dalba-workshop/Impact-Synth-Hardware/datasheet/JetsonNanoDevKitMec.jpg

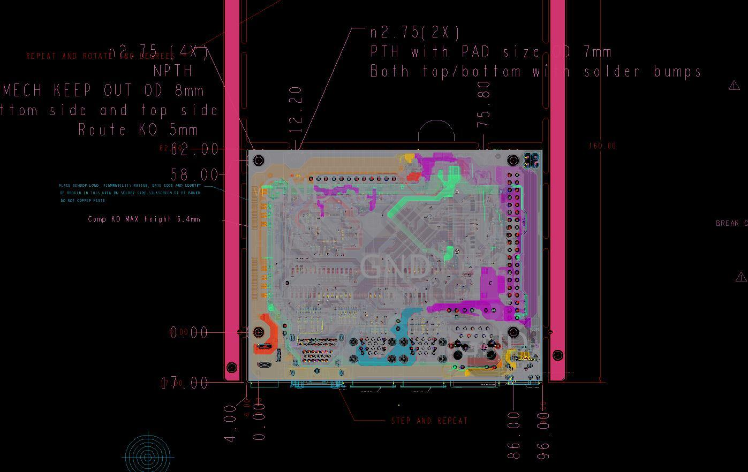
datasheet/JetsonNanoDevKitMec.jpg
