dalba-workshop/Impact-Synth-Hardware/cad/3dPrint/jnCase-Body.step

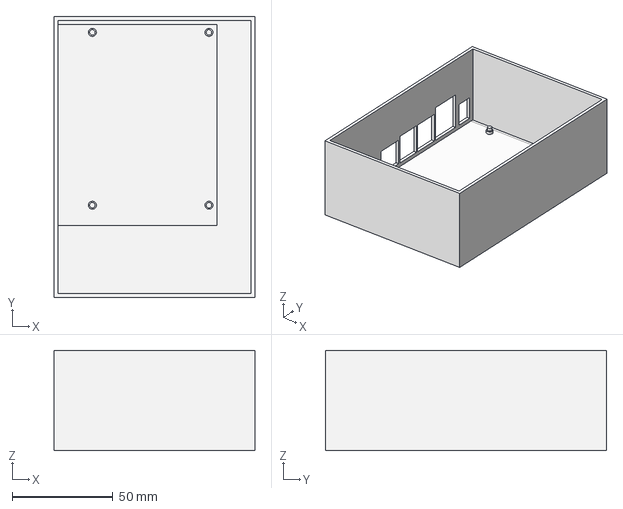
[picture p2: CAD file, 2023-01-26]
cad/3dPrint/jnCase-Body.step
100.0 x 140.0 x 50.0 mm
