dalba-workshop/Impact-Synth-Hardware/cad/case/lid.FCStd

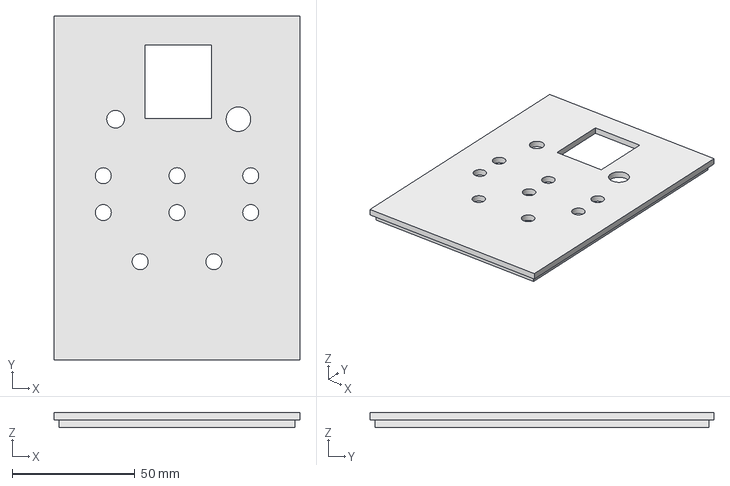
[picture p3: CAD file, 2023-01-26]
cad/case/lid.FCStd
100.0 x 140.0 x 6.00 mm
