dalba-workshop/Impact-Synth-Hardware/cad/jetsonSheild.FCStd

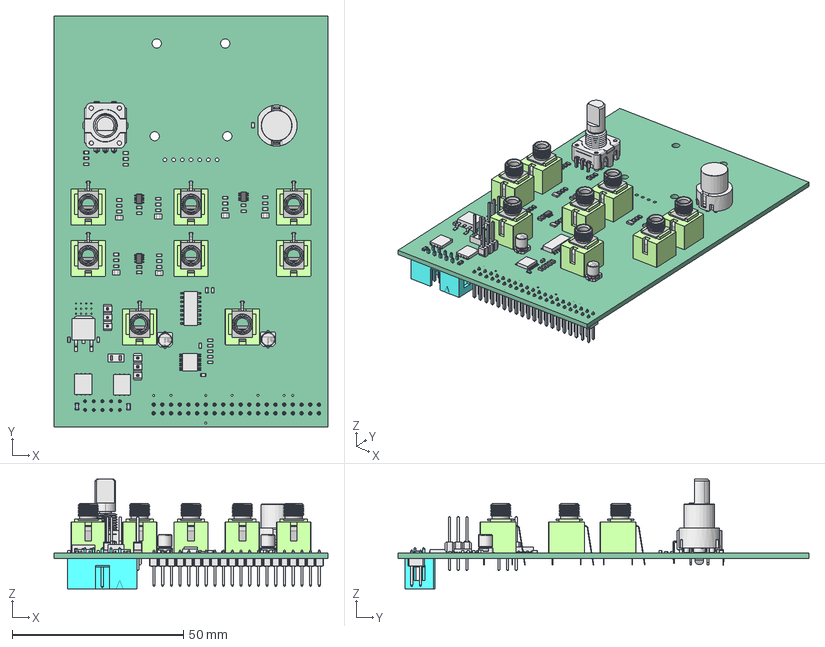
[picture p4: CAD file, 2023-01-11]
cad/jetsonSheild.FCStd
80.0 x 120.0 x 32.1 mm
Pcb_28d6
R8_R_0603_1608Metric_eae88b4e4b48 x 24
C12_C_0603_1608Metric_b996f4777426 x 18
U2_part_7a2c3e8a9f98
J14_part_9095210408f7 x 2
Q1_part_363d7e130ef1 x 2
FB2_HI0805O121R-10_937ccf488538 x 2
R18_part_2204fca52d41 x 6
Pin 3 x 8
Pin 2 x 8
Pin 1 x 8
Socket x 8
U8_part_a843a6058fb9
J15_C-87224-2_f0da443ed696
Base_Φ4Capacitor x 2
capicitor_4x5.5x1 x 2
BODY-SO x 3
LEAD-SO x 3
LEAD-SO001 x 3
LEAD-SO002 x 3
LEAD-SO003 x 3
LEAD-SO004 x 3
LEAD-SO005 x 3
LEAD-SO006 x 3
LEAD-SO007 x 3
ENC1_PEC11R-4X15F-S_891faaeb0f68
U1_part_3ea94191c17d
D6R60F2LFS_PART1
J4_78-5110-5530-9_6b1bc2c0cfd2
J2_MSBR-1_21fd95f2a57d
