dalba-workshop/Impact-Synth-Hardware/datasheet/P3448_Module.stp

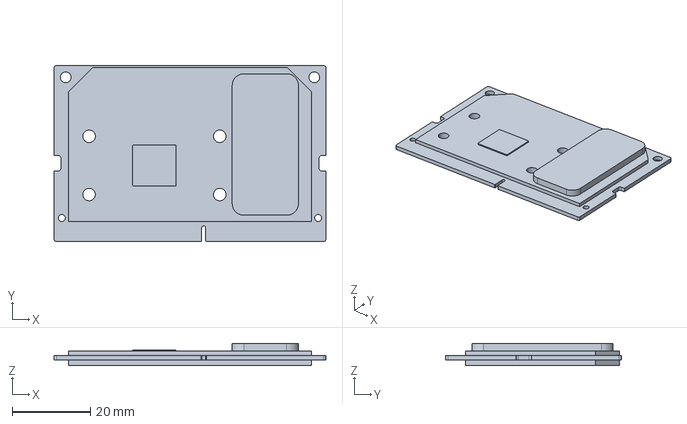
[picture p5: CAD file, 2022-12-26]
datasheet/P3448_Module.stp
69.6 x 45.0 x 5.70 mm
