dalba-workshop/Impact-Synth-Hardware/(list of files, cad)

Other CAD files:
cad/3dPrint/lid-Body.step
