dalba-workshop/Impact-Synth-Hardware/hardwareDesign/shield/shield.kicad_pcb

## KiCad design hardwareDesign/shield/shield.kicad_pcb (2023-01-12)

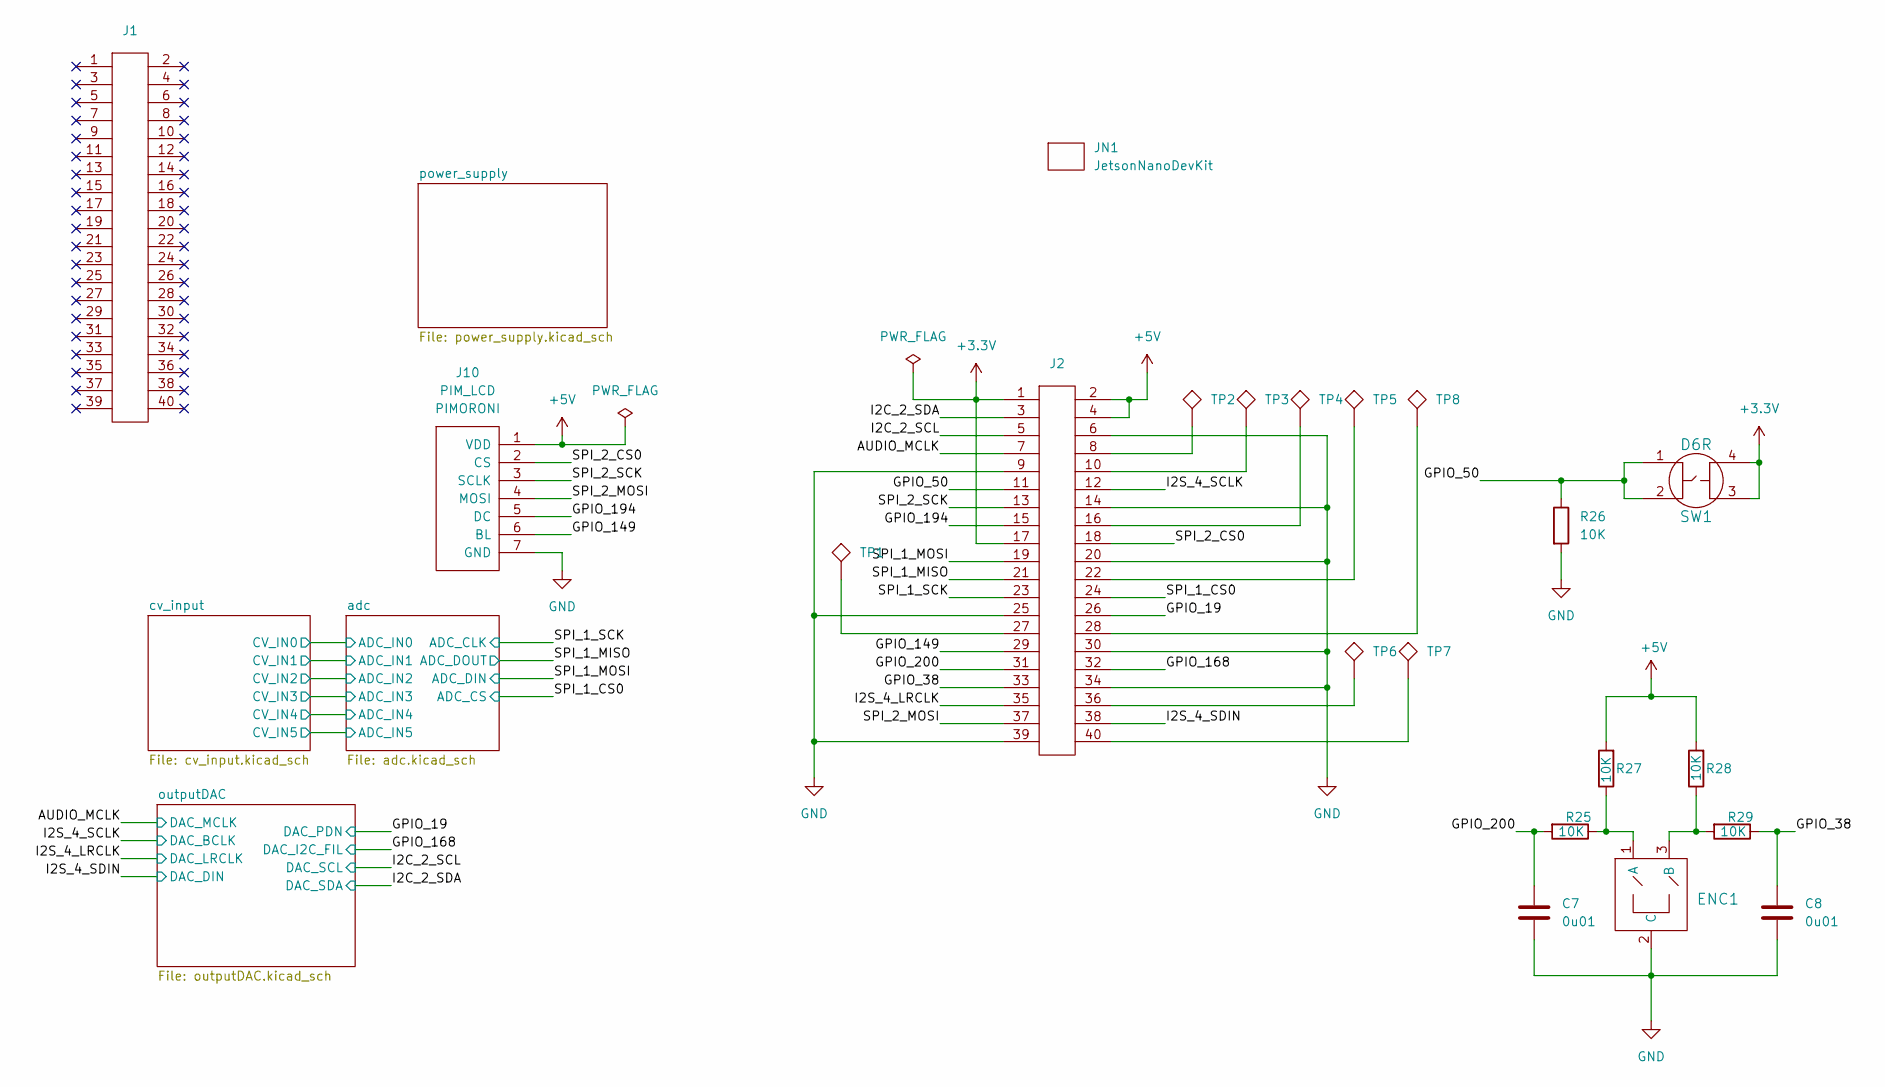
[picture p6: schematic shield.kicad_sch]

Parts:
C7, C8: 0.01uf_0603_50V; SMD_0603[1608]; Part Number VJ0603Y103KXACW1BC
ENC1: BOURNS_PEC11R_DET; BOURNS_ENCODER; Part Number PEC11R-4220F-N0024
J1: 40_POS_RIBBON; 40_POS_2.54mm; Part Number IDSD-20-D-04.00-T-G-RW
J2: 40_POS_Header; 40_POS_2.54mm; Part Number 10129381-940002BLF
J10: PIM_LCD; PIMORONI_LCD_240x240; Part Number PIMORONI_LCD_240x240
JN1: JetsonNano; jetsonNanoDev; Part Number RCG04021K00FKED
R25, R27, R28, R29: 10K_0603_2; SMD_0603[1608]; Part Number SFR03EZPF1002
R26: 10K_0603; SMD_0603[1608]; Part Number AC0603FR-0710KL
SW1: D6R; Part Number D6R60F1LFS
TP1, TP2, TP3, TP4, TP5, TP6, TP7, TP8: test_point_TH_Small; test_point_0.6mm

Connections:
+3V3: J2.1, J2.17, SW1.3, SW1.4; also elsewhere on the board
+5V: J2.2, J2.4, J10.1 (VDD), R27.2, R28.2; also elsewhere on the board
/AUDIO_MCLK: J2.7; also elsewhere on the board
/GPIO_19: J2.26; also elsewhere on the board
/GPIO_38: C8.1, J2.33, R29.1
/GPIO_50: J2.11, R26.1, SW1.1, SW1.2
/GPIO_149: J2.29, J10.6 (BL)
/GPIO_168: J2.32; also elsewhere on the board
/GPIO_194: J2.15, J10.5 (DC)
/GPIO_200: C7.1, J2.31, R25.2
/I2C_2_SCL: J2.5; also elsewhere on the board
/I2C_2_SDA: J2.3; also elsewhere on the board
/I2S_4_LRCLK: J2.35; also elsewhere on the board
/I2S_4_SCLK: J2.12; also elsewhere on the board
/I2S_4_SDIN: J2.38; also elsewhere on the board
/SPI_1_CS0: J2.24; also elsewhere on the board
/SPI_1_MISO: J2.21; also elsewhere on the board
/SPI_1_MOSI: J2.19; also elsewhere on the board
/SPI_1_SCK: J2.23; also elsewhere on the board
/SPI_2_CS0: J2.18, J10.2 (CS)
/SPI_2_MOSI: J2.37, J10.4 (MOSI)
/SPI_2_SCK: J2.13, J10.3 (SCLK)
GND: C7.2, C8.2, ENC1.2 (C), J2.6, J2.9, J2.14, J2.20, J2.25, J2.30, J2.34, J2.39, J10.7 (GND), R26.2; also elsewhere on the board
unnamed: ENC1.1 (A), R25.1, R27.1
unnamed: ENC1.3 (B), R28.1, R29.2
unnamed: J2.8, TP2.1
unnamed: J2.10, TP3.1
unnamed: J2.16, TP4.1
unnamed: J2.22, TP5.1
unnamed: J2.27, TP1.1
unnamed: J2.28, TP8.1
unnamed: J2.36, TP6.1
unnamed: J2.40, TP7.1

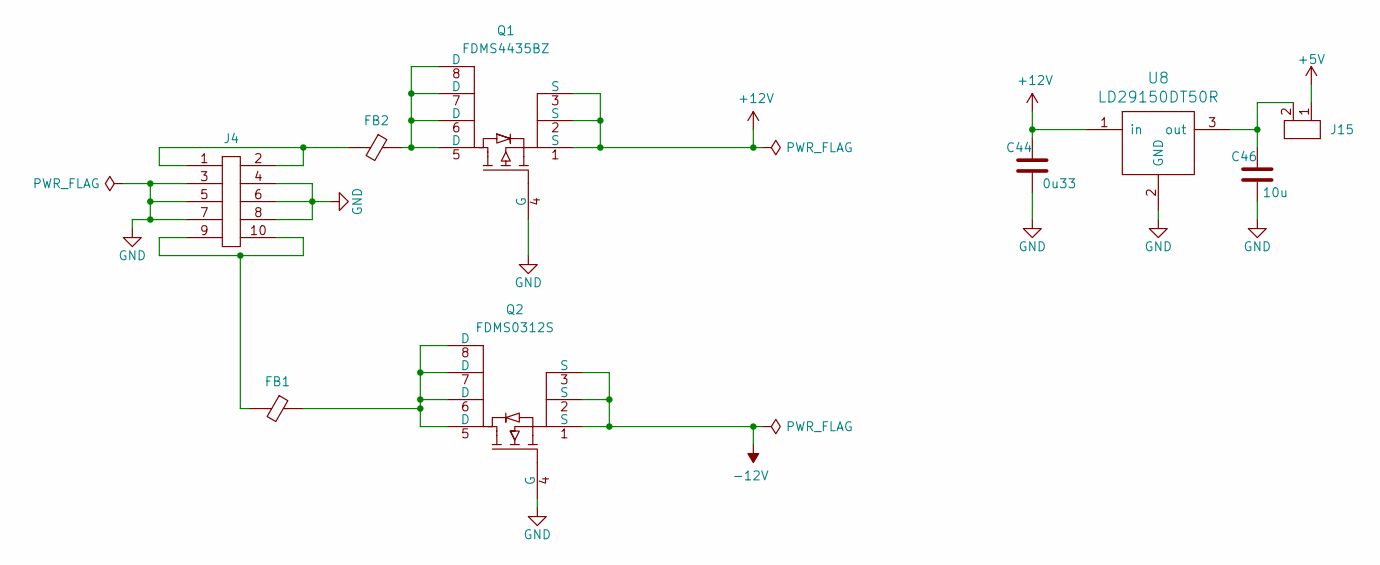
[picture p7: schematic power_supply.kicad_sch]

Parts:
C44: 0.33uf_0603_25V; SMD_0603[1608]; Part Number CC0603KRX7R8BB334
C46: 10uf_0603_25V; SMD_0603[1608]; Part Number GRT188R61E106ME13D
FB1, FB2: FB_HZ0805; Part Number HZ0805C202R-10
J4: 10_POS_PIN_HEADER_ALT; 05x02_2.54_pitch_pin_header; Part Number 61201021621
J15: 2x1_PIN_HEADER; 02x01_2.54_pitch_pin_header; Part Number 67996-400HLF
Q1: FDMS4435BZ; Power-56-8; Part Number FDMS4435BZ
Q2: FDMS0312S; Power-56-8; Part Number FDMS0312S
U8: LD29150DT50R; TO-252-3_ST; Part Number LD29150DT50R

Connections:
+5V: J15.1; also elsewhere on the board
+12V: C44.1, Q1.1 (S), Q1.2 (S), Q1.3 (S), U8.1 (in); also elsewhere on the board
-12V: Q2.1 (S), Q2.2 (S), Q2.3 (S); also elsewhere on the board
GND: C44.2, C46.2, J4.3, J4.4, J4.5, J4.6, J4.7, J4.8, Q1.4 (G), Q2.4 (G), U8.2 (GND); also elsewhere on the board
unnamed: C46.1, J15.2, U8.3 (out)
unnamed: FB1.1, Q2.5 (D), Q2.6 (D), Q2.7 (D), Q2.8 (D)
unnamed: FB1.2, J4.9, J4.10
unnamed: FB2.1, Q1.5 (D), Q1.6 (D), Q1.7 (D), Q1.8 (D)
unnamed: FB2.2, J4.1, J4.2

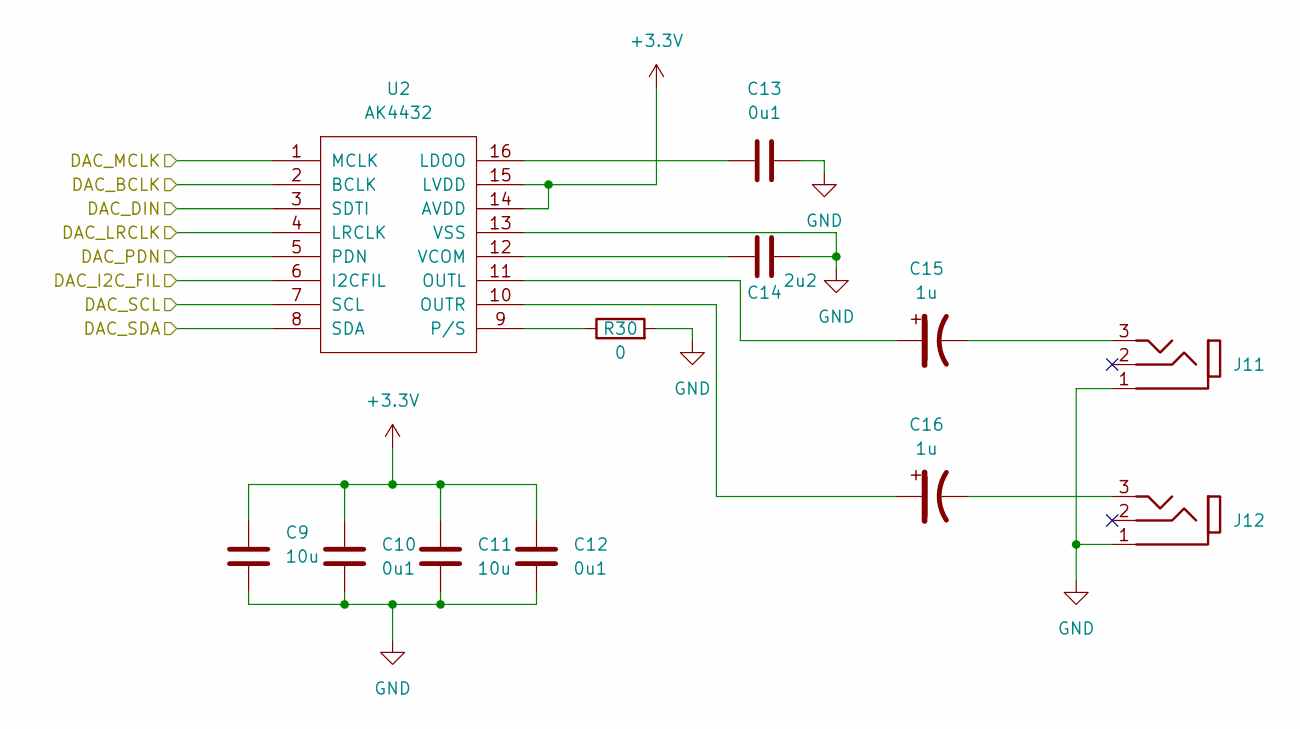
[picture p8: schematic outputDAC.kicad_sch]

Parts:
C9, C11: 10uf_0603_25V; SMD_0603[1608]; Part Number GRT188R61E106ME13D
C10, C12, C13: 0.1uf_0603_10V; SMD_0603[1608]; Part Number 885012206020
C14: 2.2uf_0603_10V; SMD_0603[1608]; Part Number 885012106011
C15, C16: 1uf_4.3mm_50V_POL_LP; WE_4mm_cap; Part Number RSVVS010M1UBC3001U
J11, J12: WQP419; Part Number WQP-WQP419GR
R30: 0_0603; SMD_0603[1608]; Part Number CRCW06030000Z0EAC
U2: AK4432; TSSOP-16; Part Number AK4432VT

Connections:
+3V3: C9.1, C10.1, C11.1, C12.1, U2.14 (AVDD), U2.15 (LVDD); also elsewhere on the board
/AUDIO_MCLK: U2.1 (MCLK); also elsewhere on the board
/GPIO_19: U2.5 (PDN); also elsewhere on the board
/GPIO_168: U2.6 (I2CFIL); also elsewhere on the board
/I2C_2_SCL: U2.7 (SCL); also elsewhere on the board
/I2C_2_SDA: U2.8 (SDA); also elsewhere on the board
/I2S_4_LRCLK: U2.4 (LRCLK); also elsewhere on the board
/I2S_4_SCLK: U2.2 (BCLK); also elsewhere on the board
/I2S_4_SDIN: U2.3 (SDTI); also elsewhere on the board
GND: C9.2, C10.2, C11.2, C12.2, C13.2, C14.1, J11.1, J12.1, R30.2, U2.13 (VSS); also elsewhere on the board
unnamed: C13.1, U2.16 (LDOO)
unnamed: C14.2, U2.12 (VCOM)
unnamed: C15.1, J11.3
unnamed: C15.2, U2.11 (OUTL)
unnamed: C16.1, J12.3
unnamed: C16.2, U2.10 (OUTR)
unnamed: R30.1, U2.9 (P/S)

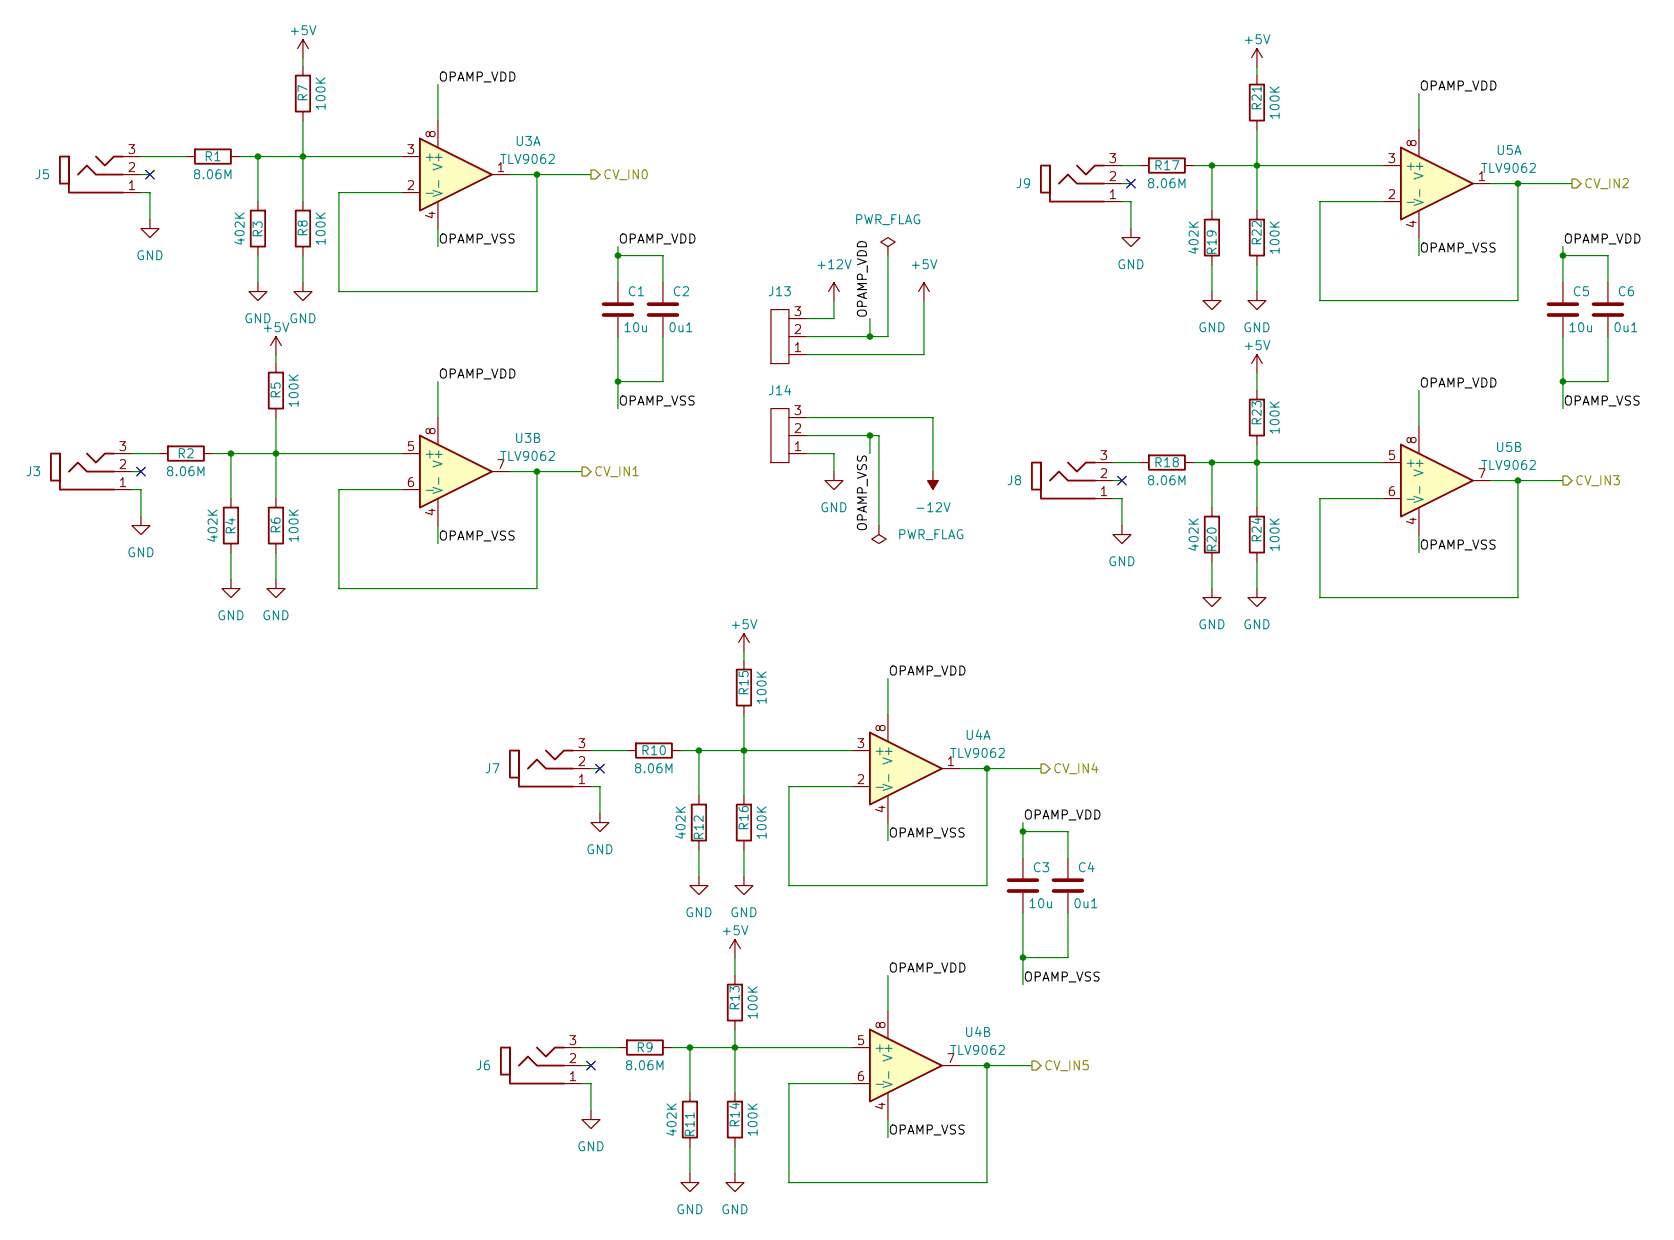
[picture p9: schematic cv_input.kicad_sch]

Parts:
C1, C3, C5: 10uf_0603_25V; SMD_0603[1608]; Part Number GRT188R61E106ME13D
C2, C4, C6: 0.1uf_0603_10V; SMD_0603[1608]; Part Number 885012206020
J3, J5, J6, J7, J8, J9: WQP419; Part Number WQP-WQP419GR
J13, J14: 3x1_PIN_HEADER; 03x01_2.54_pitch_pin_header; Part Number 10129378-903001BLF
R1, R2, R9, R10, R17, R18: 8.06M_0805; SMD_0805[2012]; Part Number RC0805FR-078M06L
R3, R4, R11, R12, R19, R20: 402K_0603; SMD_0603[1608]; Part Number RT0603FRE07402KL
R5, R6, R7, R8, R13, R14, R15, R16, R21, R22, R23, R24: 100K_0603; SMD_0603[1608]; Part Number ERJ-3EKF1003V
U3, U4, U5: TLV9062; SOT23-8; Part Number TLV9062IDDFR

Connections:
+5V: J13.1, R5.2, R7.2, R13.2, R15.2, R21.2, R23.2; also elsewhere on the board
+12V: J13.3; also elsewhere on the board
-12V: J14.3; also elsewhere on the board
/adc/ADC_IN0: U3.1, U3.2 (-); also elsewhere on the board
/adc/ADC_IN1: U3.6 (-), U3.7; also elsewhere on the board
/adc/ADC_IN2: U5.1, U5.2 (-); also elsewhere on the board
/adc/ADC_IN3: U5.6 (-), U5.7; also elsewhere on the board
/adc/ADC_IN4: U4.1, U4.2 (-); also elsewhere on the board
/adc/ADC_IN5: U4.6 (-), U4.7; also elsewhere on the board
/cv_input/OPAMP_VDD: C1.1, C2.1, C3.1, C4.1, C5.1, C6.1, J13.2, U3.8 (V+), U4.8 (V+), U5.8 (V+)
/cv_input/OPAMP_VSS: C1.2, C2.2, C3.2, C4.2, C5.2, C6.2, J14.2, U3.4 (V-), U4.4 (V-), U5.4 (V-)
GND: J3.1, J5.1, J6.1, J7.1, J8.1, J9.1, J14.1, R3.1, R4.1, R6.1, R8.1, R11.1, R12.1, R14.1, R16.1, R19.1, R20.1, R22.1, R24.1; also elsewhere on the board
unnamed: J3.3, R2.2
unnamed: J5.3, R1.2
unnamed: J6.3, R9.2
unnamed: J7.3, R10.2
unnamed: J8.3, R18.2
unnamed: J9.3, R17.2
unnamed: R1.1, R3.2, R7.1, R8.2, U3.3 (+)
unnamed: R2.1, R4.2, R5.1, R6.2, U3.5 (+)
unnamed: R10.1, R12.2, R15.1, R16.2, U4.3 (+)
unnamed: R9.1, R11.2, R13.1, R14.2, U4.5 (+)
unnamed: R17.1, R19.2, R21.1, R22.2, U5.3 (+)
unnamed: R18.1, R20.2, R23.1, R24.2, U5.5 (+)

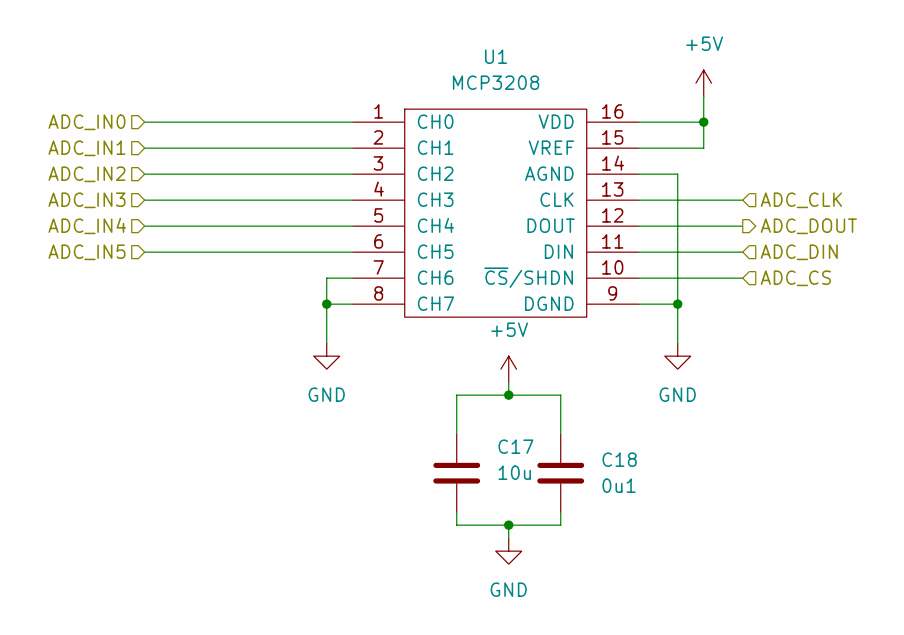
[picture p10: schematic adc.kicad_sch]

Parts:
C17: 10uf_0603_25V; SMD_0603[1608]; Part Number GRT188R61E106ME13D
C18: 0.1uf_0603_10V; SMD_0603[1608]; Part Number 885012206020
U1: MCP3208; SOIC-16; Part Number MCP3208-CI/SL

Connections:
+5V: C17.1, C18.1, U1.15 (VREF), U1.16 (VDD); also elsewhere on the board
/SPI_1_CS0: U1.10 (~CS/SHDN); also elsewhere on the board
/SPI_1_MISO: U1.12 (DOUT); also elsewhere on the board
/SPI_1_MOSI: U1.11 (DIN); also elsewhere on the board
/SPI_1_SCK: U1.13 (CLK); also elsewhere on the board
/adc/ADC_IN0: U1.1 (CH0); also elsewhere on the board
/adc/ADC_IN1: U1.2 (CH1); also elsewhere on the board
/adc/ADC_IN2: U1.3 (CH2); also elsewhere on the board
/adc/ADC_IN3: U1.4 (CH3); also elsewhere on the board
/adc/ADC_IN4: U1.5 (CH4); also elsewhere on the board
/adc/ADC_IN5: U1.6 (CH5); also elsewhere on the board
GND: C17.2, C18.2, U1.7 (CH6), U1.8 (CH7), U1.9 (DGND), U1.14 (AGND); also elsewhere on the board

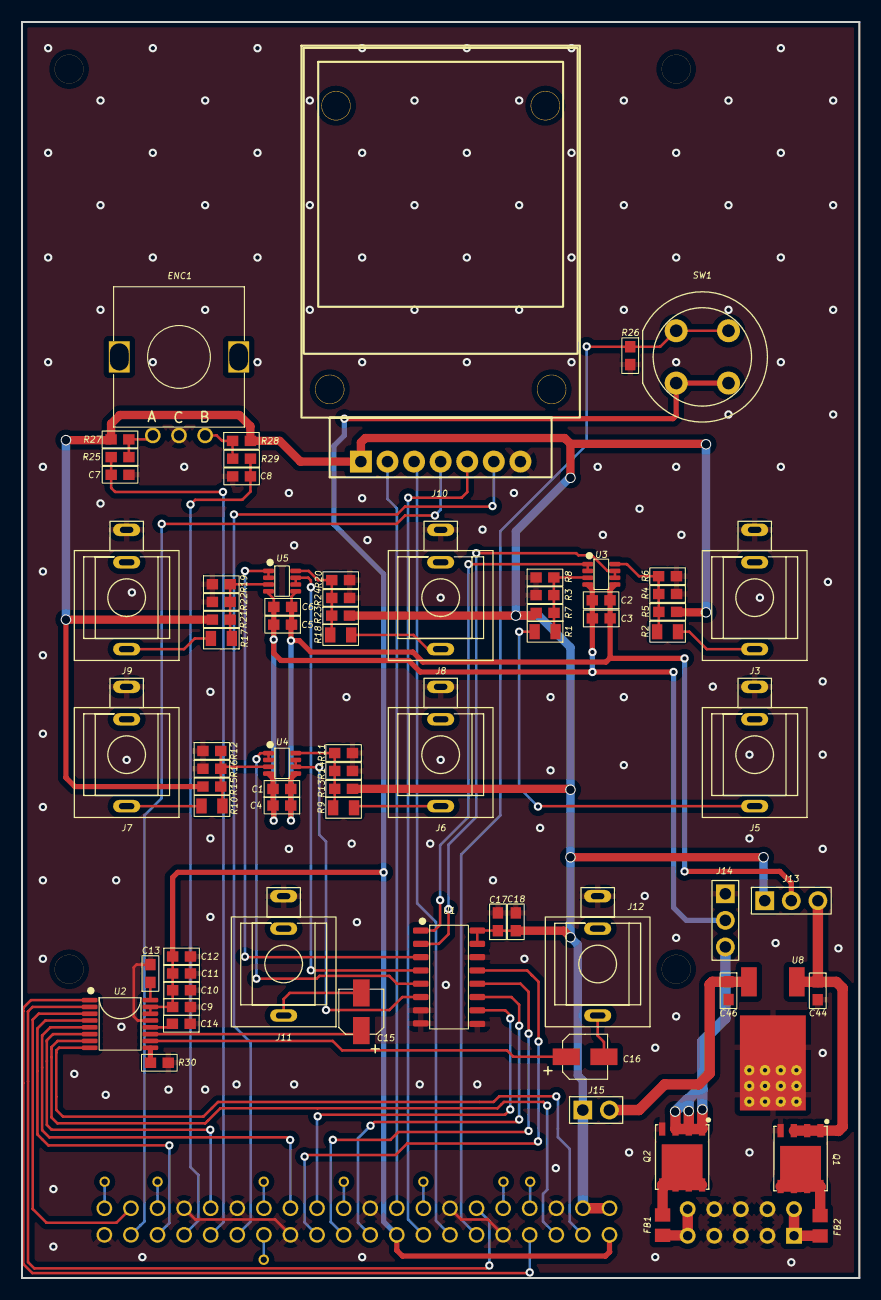
[picture p11: board shield.kicad_pcb from above]

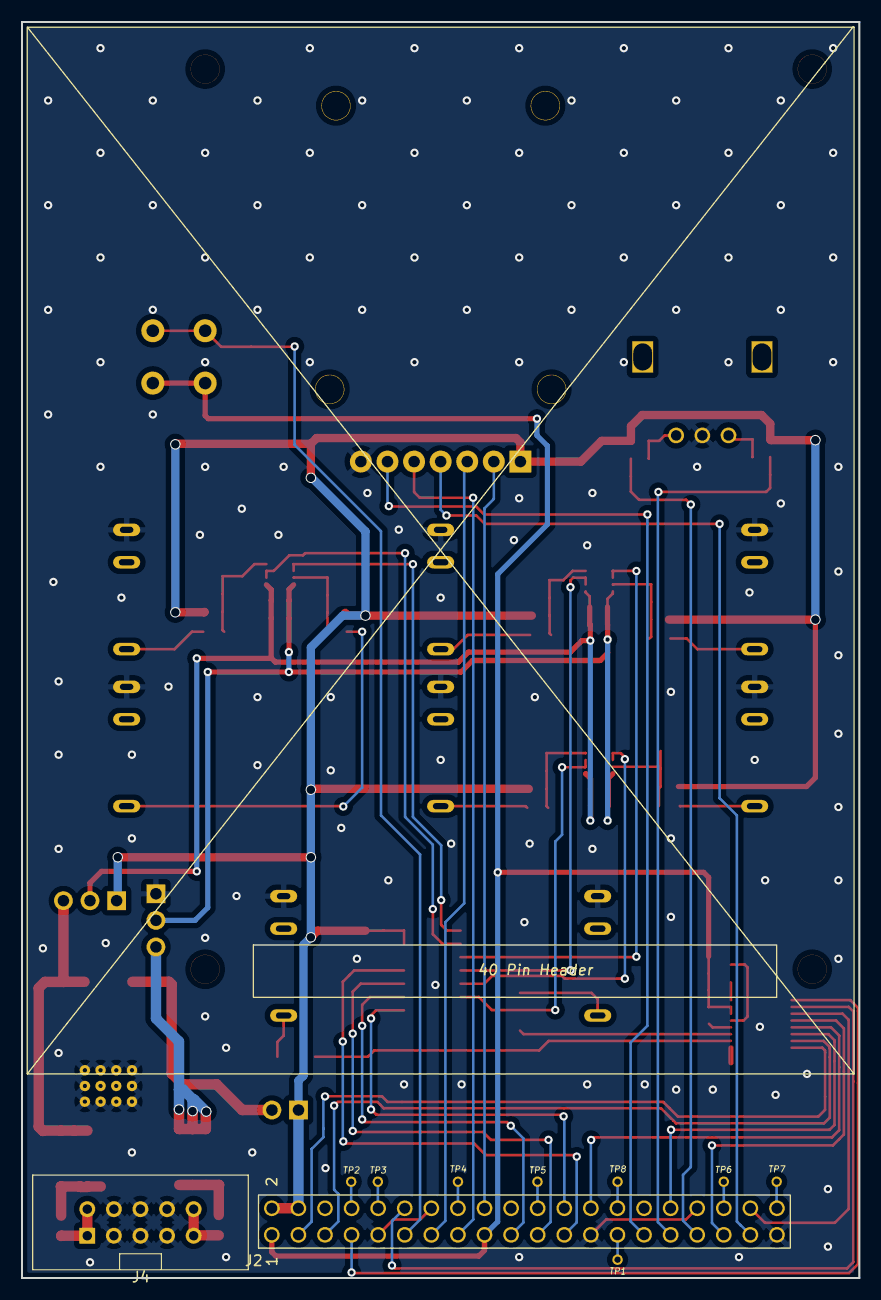
[picture p12: board shield.kicad_pcb from below]

Board: 2 copper layers, 80.0 x 120.0 mm, 85 parts (11 on the bottom side), 67 nets.
