dalba-workshop/Impact-Synth-Hardware/(commit log)

2022-12-26 Added datasheets, started hardware deign
    [P3448_Module.stp, power_supply.kicad_sch, shield.kicad_pcb, shield.kicad_sch]
2022-12-31 Schematic done
    [Jetson-Nano-GPIO-mapping.xlsx, NV_Jetson_Nano_Module_Pinmux_Config_Template.xlsm, adc.kicad_sch, cv_input.kicad_sch, outputDAC.kicad_sch, power_supply.kicad_sch, shield.kicad_pcb, shield.kicad_sch]
2023-01-07 Finished schematic and PCB for jetson Nano Sheild
    [adc.kicad_sch, cv_input.kicad_sch, jetsonSheild.FCStd, power_supply.kicad_sch, shield.kicad_pcb, shield.kicad_sch]
2023-01-10 Board layout done and parts ordered
    [PO052302167 — DIGI-KEY.csv, PO327584194 — MOUSER.csv, shield.csv]
2023-01-11 Finished layout with JN real footprint
    [jetsonSheild.FCStd, outputDAC.kicad_sch, power_supply.kicad_sch, shield.kicad_pcb, shield.kicad_sch]
2023-01-12 Checked mechanica fit
    [shield-B_Cu.gbl, shield-B_Mask.gbs, shield-B_Paste.gbp, shield-B_Silkscreen.gbo, shield-Edge_Cuts.gm1, shield-F_Cu.gtl, shield-F_Mask.gts, shield-F_Paste.gtp]
2023-01-22 fab files
    [shield-B_Cu.gbl, shield-B_Mask.gbs, shield-B_Paste.gbp, shield-B_Silkscreen.gbo, shield-Edge_Cuts.gm1, shield-F_Cu.gtl, shield-F_Mask.gts, shield-F_Paste.gtp]
2023-01-26 Created 3d model for case
    [jnCase-Body.step, lid-Body.step, lid.FCStd]
